tapiwaaajpeg/microgrid-esp32-controller/(commit log)

2026-10-05 Revise README for microgrid ESP32 controller
    Updated project title and expanded the README with detailed descriptions, features, results, system architecture, hardware specifications, and calibration instructions for the ESP32-based microgrid controller.
2026-10-05 Implement microgrid controller firmware
    This firmware implements an intelligent predictive protection and optimization system for microgrids using an ESP32. It features load energization, dual-relay switching, current and voltage sensing, and an OLED display.
